kanisakhpara-devs/holographic-hullabaloo/pcb/hub/hub.csv

Reference | Qty | Value | DNP | Exclude from BOM | Exclude from Board | Exclude from Simulation | Footprint | Datasheet | LCSC Part
C1,C6,C9,C11,C18,C21,C23,C24 | 8 | 100nF |  |  |  |  | Capacitor_SMD:C_0402_1005Metric |  | C1525
C2,C4,C7,C8,C13,C14,C15,C17,C20 | 9 | 22uF |  |  |  |  | Capacitor_SMD:C_0805_2012Metric |  | C45783
C3,C22 | 2 | 1uF |  |  |  |  | Capacitor_SMD:C_0402_1005Metric |  | C52923
C5,C10,C16,C19 | 4 | 10uF |  |  |  |  | Capacitor_SMD:C_0603_1608Metric |  | C19702
C12 | 1 | 10nF |  |  |  |  | Capacitor_SMD:C_0402_1005Metric |  | TBD
CN1 | 1 | S2B-PH-SM4-TB |  |  |  |  | fallen:CONN-SMD_P2.00_S2B-PH-SM4-TB-LF-SN | https://lcsc.com/product-detail/_JST-Sales-America_S2B-PH-SM4-TB-LF-SN_JST-Sales-America-S2B-PH-SM4-TB-LF-SN_C295747.html | C295747
D1 | 1 | USBLC6-2SC6 |  |  |  |  | fallen:SOT-23-6_L2.9-W1.6-P0.95-LS2.8-BL | https://lcsc.com/product-detail/Diodes-ESD_STMicroelectronics_USBLC6-2SC6_USBLC6-2SC6_C7519.html | C7519
D2,D3 | 2 | SS34_C8678 |  |  |  |  | fallen:SMA_L4.3-W2.6-LS5.2-RD | https://lcsc.com/product-detail/Schottky-Barrier-Diodes-SBD_SS34_C8678.html | C8678
D4 | 1 | LED |  |  |  |  | LED_SMD:LED_0603_1608Metric |  | TBD
J1 | 1 | Conn_01x02 |  |  |  |  | Connector_PinHeader_2.54mm:PinHeader_1x02_P2.54mm_Vertical
J2,J3 | 2 | Conn_01x06 |  |  |  |  | Connector_PinHeader_2.54mm:PinHeader_1x06_P2.54mm_Vertical
L1 | 1 | SWPA8040S2R2MT |  |  |  |  | fallen:IND-SMD_L8.0-W8.0_SWPA8040S | https://lcsc.com/product-detail/Power-Inductors_2-2uH-30_C36415.html | C36415
Q1,Q2 | 2 | AO3401A |  |  |  |  | fallen:SOT-23_L2.9-W1.3-P1.90-LS2.4-BR | https://lcsc.com/product-detail/MOSFET_AOS_AO3401A_AO3401A_C15127.html | C15127
Q3 | 1 | 2N7002 |  |  |  |  | fallen:SOT-23-3_L2.9-W1.3-P1.90-LS2.4-BR | https://lcsc.com/product-detail/MOSFET_2N7002-7002_C8545.html | C8545
R1,R2 | 2 | 5.1k |  |  |  |  | Resistor_SMD:R_0402_1005Metric |  | C25905
R3 | 1 | 1.1k |  |  |  |  | Resistor_SMD:R_0402_1005Metric |  | TBD
R4,R9,R10,R11,R16,R17,R18 | 7 | 100k |  |  |  |  | Resistor_SMD:R_0402_1005Metric |  | C25741
R5,R6,R8,R14,R19,R20,R30 | 7 | 10k |  |  |  |  | Resistor_SMD:R_0402_1005Metric |  | C25744
R7 | 1 | 1.18k |  |  |  |  | Resistor_SMD:R_0402_1005Metric |  | TBD
R12 | 1 | 330k |  |  |  |  | Resistor_SMD:R_0402_1005Metric |  | TBD
R13 | 1 | 267k |  |  |  |  | Resistor_SMD:R_0402_1005Metric |  | TBD
R15 | 1 | 316k |  |  |  |  | Resistor_SMD:R_0402_1005Metric |  | TBD
R21 | 1 | 1k |  |  |  |  | Resistor_SMD:R_0402_1005Metric |  | TBD
R22,R23,R24,R25,R26,R27,R28,R29 | 8 | 33 |  |  |  |  | Resistor_SMD:R_0402_1005Metric |  | C25105
SW1 | 1 | MSK12C02 |  |  |  |  | fallen:SW-TH_MSK12C02 | https://lcsc.com/product-detail/Toggle-Switches_SHOU-HAN-MSK12C02_C431540.html | C431540
SW2,SW3 | 2 | TS-1187A-B-A-B |  |  |  |  | fallen:SW-SMD_4P-L5.1-W5.1-P3.70-LS6.5-TL_H1.5 | https://lcsc.com/product-detail/Tactile-Switches_XKB-Enterprise-TS-1187-B-A-A_C318884.html | C318884
TP1,TP2 | 2 | TestPoint |  |  |  |  | TestPoint:TestPoint_Pad_D1.0mm
U1 | 1 | BQ24073RGTR |  |  |  |  | fallen:QFN-16_L3.0-W3.0-P0.50-TL-EP1.7 | https://lcsc.com/product-detail/PMIC-Battery-Management_TI_BQ24073RGTR_BQ24073RGTR_C15220.html | C15220
U2 | 1 | TPS61088RHLR |  |  |  |  | fallen:VQFN-20_L4.6-W3.6-P0.50-BL | https://lcsc.com/product-detail/DC-DC-Converters_TI_TPS61088RHLR_TPS61088RHLR_C87357.html | C87357
U3 | 1 | AMS1117-3.3 |  |  |  |  | fallen:SOT-223-3_L6.5-W3.4-P2.30-LS7.0-BR | https://lcsc.com/product-detail/Low-Dropout-Regulators-LDO_AMS_AMS1117-3-3_AMS1117-3-3_C6186.html | C6186
U4 | 1 | ESP32-S3-WROOM-1-N8 |  |  |  |  | fallen:WIFIM-SMD_ESP32-S3-WROOM-1-N8 | https://www.lcsc.com/datasheet/C2913198.pdf | C2913198
U5 | 1 | 74AHCT245APWJ |  |  |  |  | fallen:TSSOP-20_L6.5-W4.4-P0.65-LS6.4-BL | https://lcsc.com/product-detail/presales_Nexperia-74AHCT245APWJ_C554610.html | C554610
U6 | 1 | DRV5023FAQDBZR |  |  |  |  | fallen:SOT-23-3_L2.9-W1.6-P1.90-LS2.8-BR | https://lcsc.com/product-detail/Others_Texas-Instruments_DRV5023FAQDBZR_Texas-Instruments-TI-DRV5023FAQDBZR_C114983.html | C114983
USB1 | 1 | TYPE-C 16PIN 2MD |  |  |  |  | fallen:USB-C-SMD_TYPE-C-16PIN-2MD-073 | https://www.lcsc.com/datasheet/C2765186.pdf | C2765186
