kanisakhpara-devs/holographic-hullabaloo/firmware/base/src/motor.cpp

#include "motor.h"

void motor_begin() {
  // TODO: see comment in motor.h
}

void motor_set_target(bool spin) {
  // TODO: see comment in motor.h
}

void motor_update(uint16_t rotor_rev_us) {
  // TODO: see comment in motor.h
}
