kanisakhpara-devs/holographic-hullabaloo/firmware/base/src/radio_tx.cpp

#include "radio_tx.h"

void radio_begin() {
  // TODO: see comment in radio_tx.h
}

void radio_update(uint32_t now_ms) {
  // TODO: see comment in radio_tx.h
}

uint16_t radio_rotor_rev_us() {
  // TODO: see comment in radio_tx.h
  return 0;
}
