kanisakhpara-devs/holographic-hullabaloo/firmware/rotor/src/framebuffer.cpp

#include "framebuffer.h"

void fb_begin() {
  // TODO: see comment in framebuffer.h
}

void fb_swap() {
  // TODO: see comment in framebuffer.h
}

uint32_t fb_estimated_ma() {
  // TODO: see comment in framebuffer.h
  return 0;
}
