kanisakhpara-devs/holographic-hullabaloo/firmware/rotor/src/hall_timing.cpp

#include "hall_timing.h"

void hall_begin() {
  // TODO: see comment in hall_timing.h
}

uint32_t hall_rev_us() {
  // TODO: see comment in hall_timing.h
  return 0;
}

bool hall_spinning() {
  // TODO: see comment in hall_timing.h
  return false;
}
