kanisakhpara-devs/holographic-hullabaloo/firmware/rotor/src/led_output.cpp

#include "led_output.h"

void led_begin() {
  // TODO: see comment in led_output.h
}

void led_power(bool on) {
  // TODO: see comment in led_output.h
}

void led_send_column(uint16_t column) {
  // TODO: see comment in led_output.h
}
