kanisakhpara-devs/holographic-hullabaloo/firmware/rotor/src/power.cpp

#include "power.h"

void power_begin() {
  // TODO: see comment in power.h
}

uint16_t power_battery_mv() {
  // TODO: see comment in power.h
  return 0;
}

bool power_good() {
  // TODO: see comment in power.h
  return false;
}

bool power_charging() {
  // TODO: see comment in power.h
  return false;
}
