kanisakhpara-devs/holographic-hullabaloo/firmware/rotor/src/radio_rx.cpp

#include "radio_rx.h"

void radio_begin() {
  // TODO: see comment in radio_rx.h
}

bool radio_have_state() {
  // TODO: see comment in radio_rx.h
  return false;
}

uint32_t radio_last_packet_ms() {
  // TODO: see comment in radio_rx.h
  return 0;
}
