kanisakhpara-devs/holographic-hullabaloo/(commit log)

2026-11-08 Create cad
2026-11-09 Rename BOM - Sheet1.csv to bom.csv
    [bom.csv]
2026-11-10 Rename bom - Sheet1 (1).csv to bom.csv
    [bom.csv]
2026-11-11 Rename bom - Sheet1 (2).csv to bom.csv
    [bom.csv]
2026-11-12 updated the KiCad schem for the powersheet only
    [hub.kicad_pcb, hub.kicad_sch, led_io.kicad_sch, mcu_usb.kicad_sch, power.kicad_sch]
2026-11-12 updated the KiCad schem
2026-11-13 the entire finished hub schem
    [led_io.kicad_sch, mcu_usb.kicad_sch, power.kicad_sch]
2026-11-13 finishe 6 hours of work
    [hub.csv, led_io.kicad_sch, mcu_usb.kicad_sch, power.kicad_sch]
2026-11-14 saturday's work
    [blade.kicad_pcb, blade.kicad_sch]
